sjasi3/ECE445/notebooks/Sean/ECE445 Journal/Pasted image 20260427105520.png

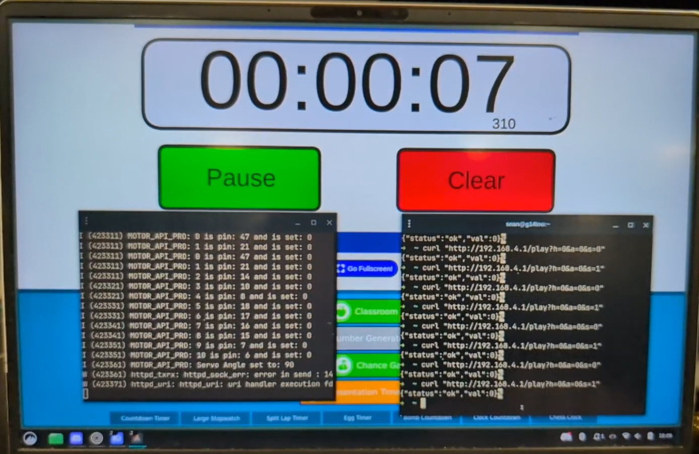
notebooks/Sean/ECE445 Journal/Pasted image 20260427105520.png
