sjasi3/ECE445/notebooks/Sean/ECE445 Journal/Pasted image 20260310155944.png

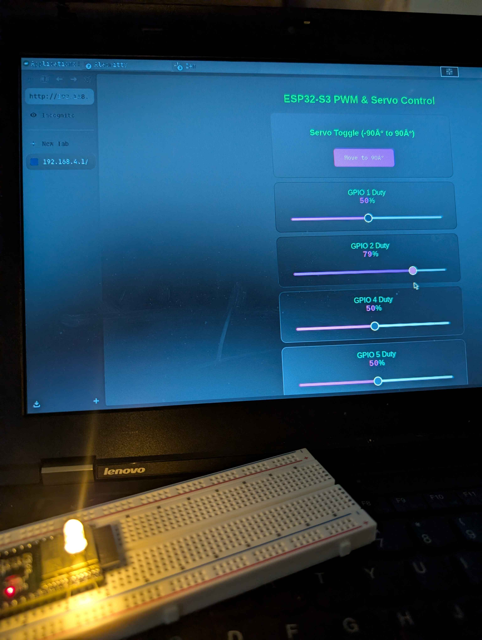
notebooks/Sean/ECE445 Journal/Pasted image 20260310155944.png
