sjasi3/ECE445/notebooks/David/image.png

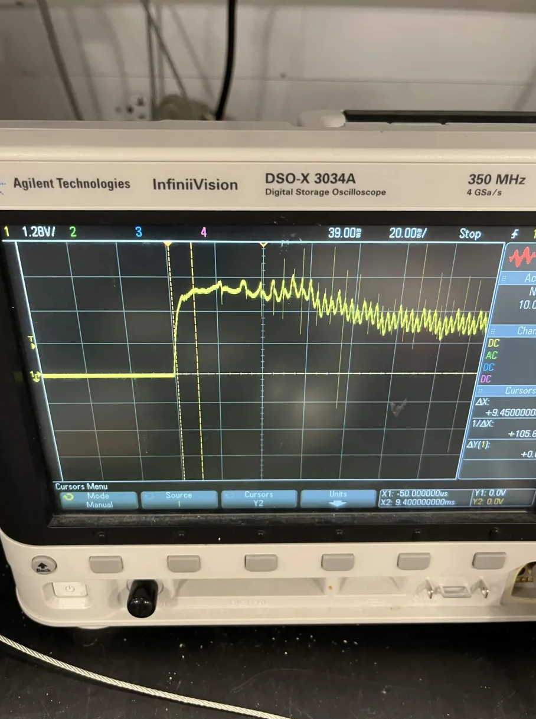
notebooks/David/image.png
