sjasi3/ECE445/notebooks/David/IMG_9398.jpg

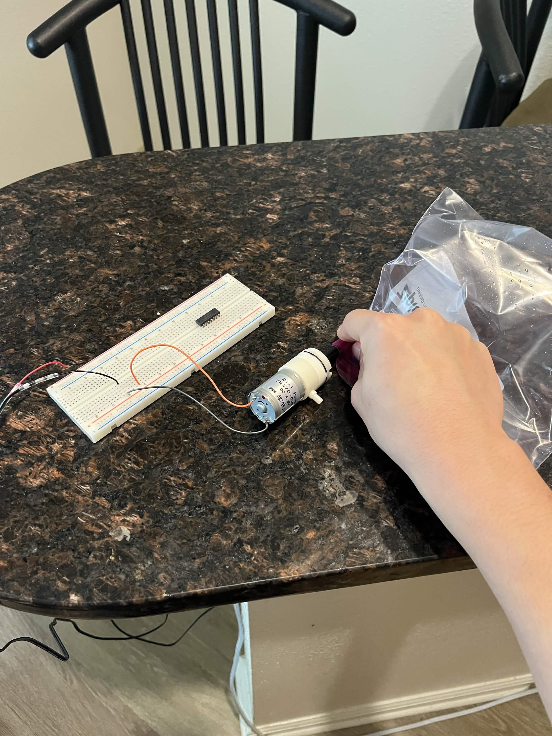
notebooks/David/IMG_9398.jpg
