sjasi3/ECE445/notebooks/David/IMG_9528.jpg

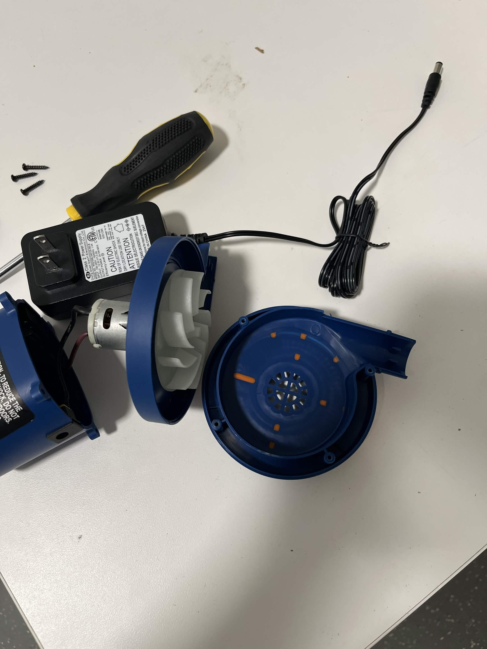
notebooks/David/IMG_9528.jpg
