sjasi3/ECE445/notebooks/David/IMG_9540.jpg

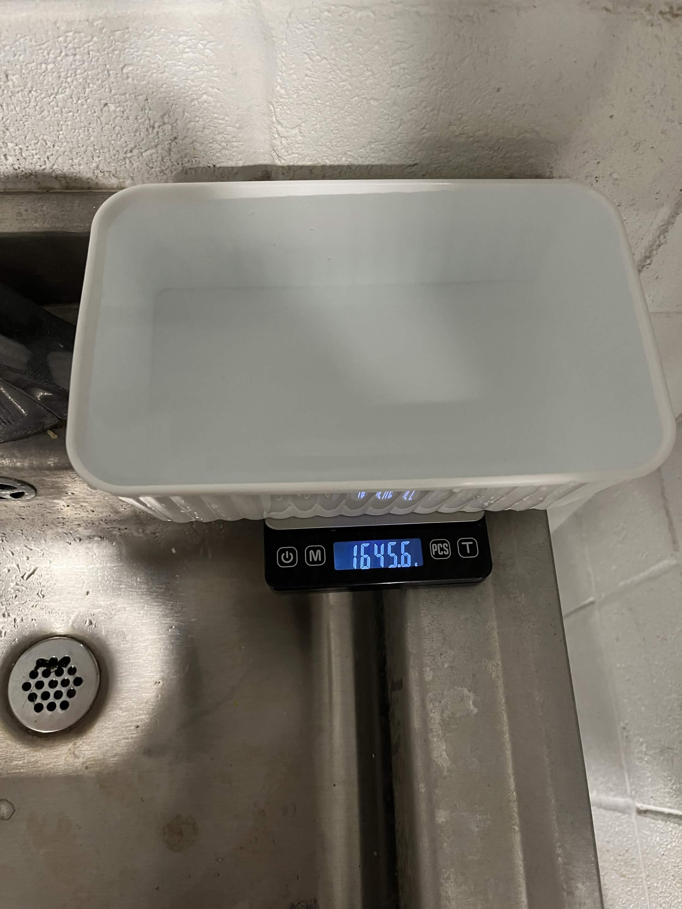
notebooks/David/IMG_9540.jpg
