sjasi3/ECE445/notebooks/David/IMG_9541.jpg

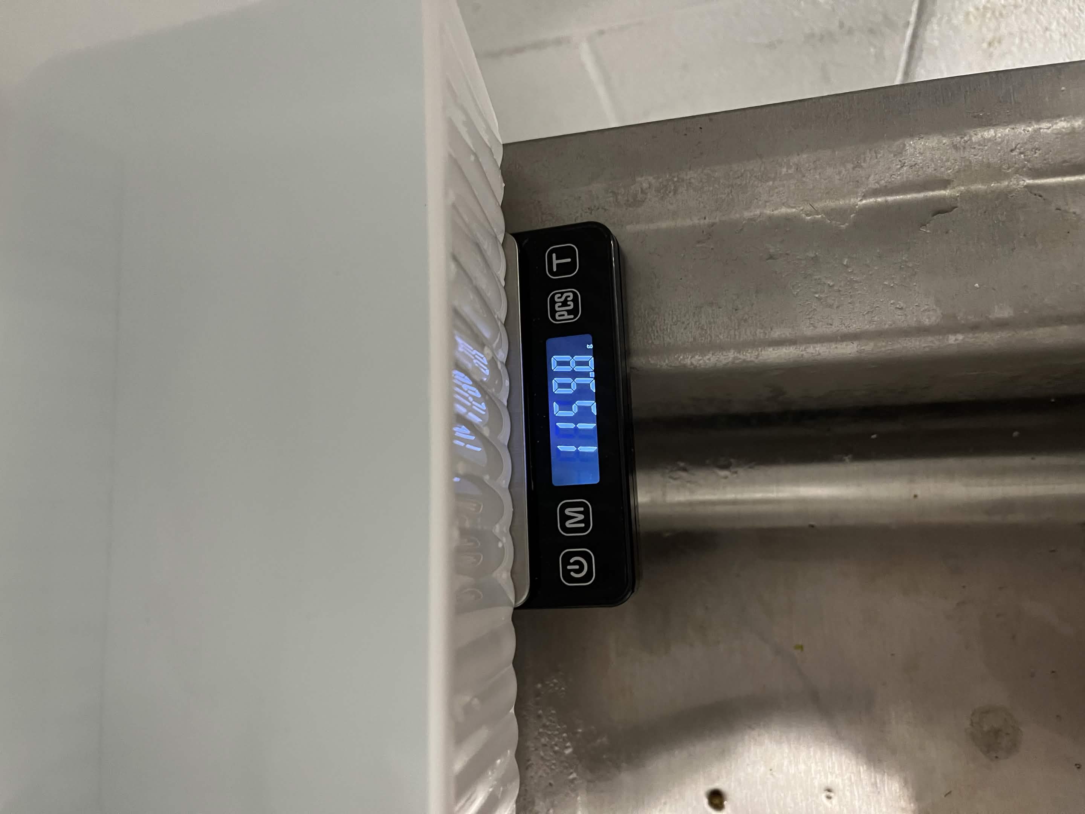
notebooks/David/IMG_9541.jpg
