sjasi3/ECE445/notebooks/robertz4/2_26 PCB Design/2_26 Figure 2 Types of motor and solenoid drivers.jpg

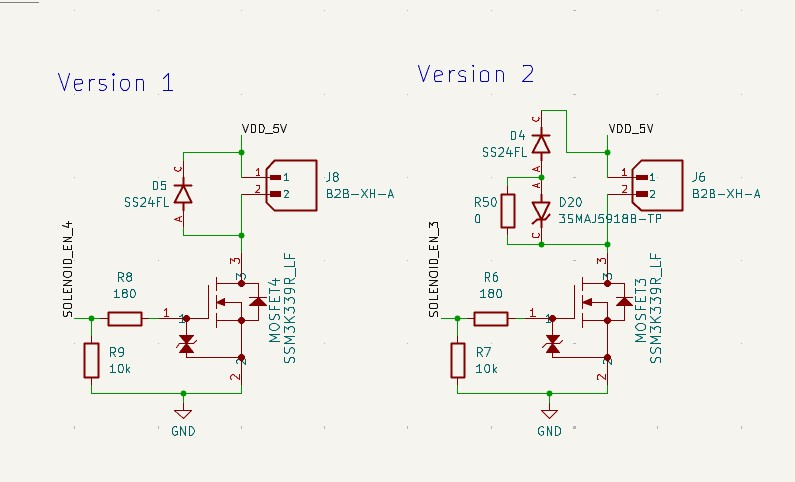
notebooks/robertz4/2_26 PCB Design/2_26 Figure 2 Types of motor and solenoid drivers.jpg
