sjasi3/ECE445/notebooks/robertz4/3_9 Prototyping for breadboard demo/3_9 Figure 4 solenoid current profile.jpg

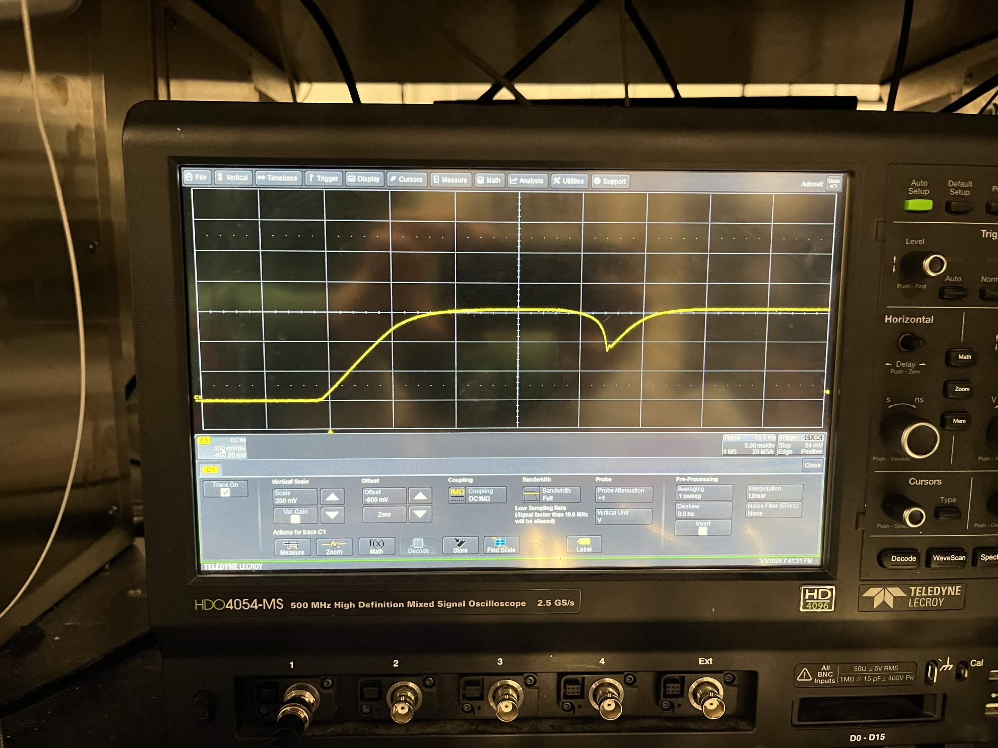
notebooks/robertz4/3_9 Prototyping for breadboard demo/3_9 Figure 4 solenoid current profile.jpg
