sjasi3/ECE445/notebooks/robertz4/3_9 Prototyping for breadboard demo/3_9 Figure 5 noise plot.jpg

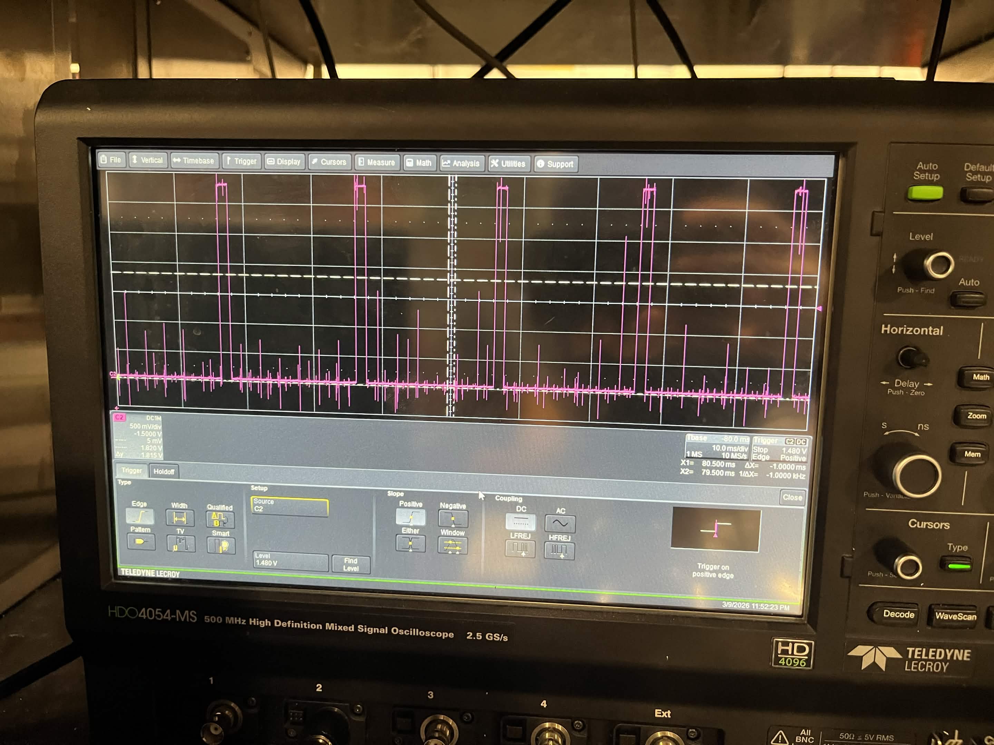
notebooks/robertz4/3_9 Prototyping for breadboard demo/3_9 Figure 5 noise plot.jpg
