sjasi3/ECE445/notebooks/robertz4/4_24 CAD for final demo/t_joint_v2.stl

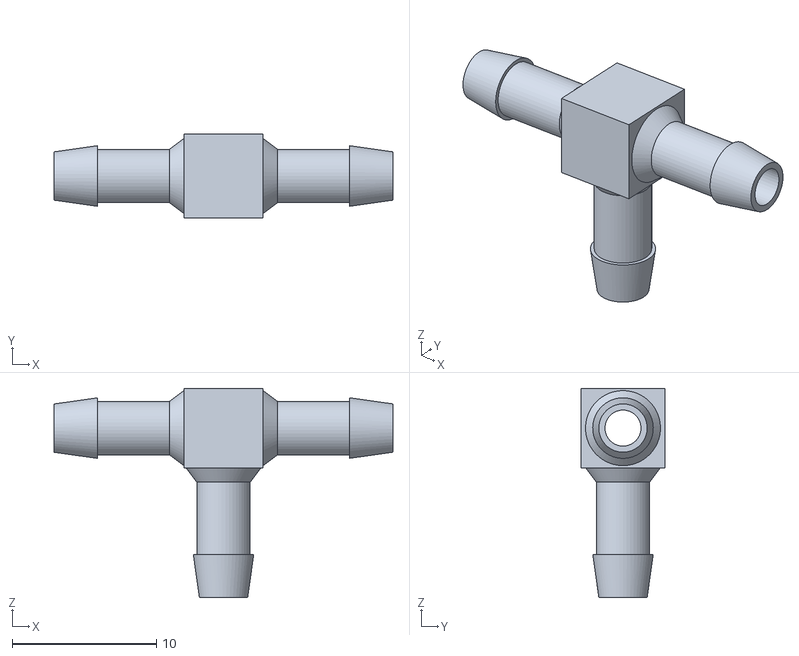
[picture p11: CAD file, 2026-04-27]
notebooks/robertz4/4_24 CAD for final demo/t_joint_v2.stl
23.5 x 5.80 x 14.5
