sjasi3/ECE445/notebooks/robertz4/4_24 CAD for final demo/solenoid_cap_v6.stl

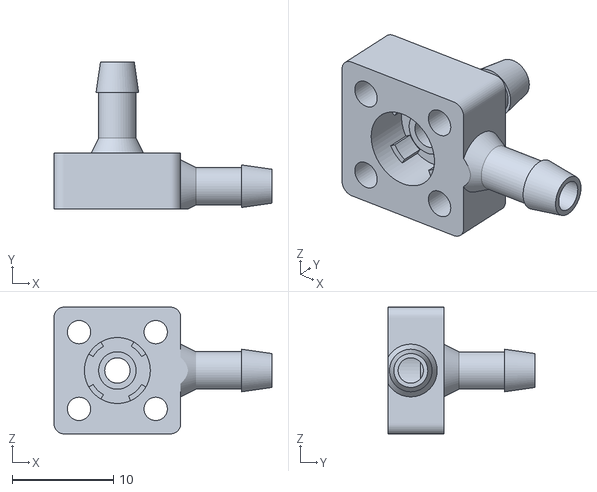
[picture p12: CAD file, 2026-04-27]
notebooks/robertz4/4_24 CAD for final demo/solenoid_cap_v6.stl
21.5 x 14.5 x 12.5
