sjasi3/ECE445/notebooks/robertz4/4_25 Testing for final demo/4_25 Figure 9 3.3V ripple.png

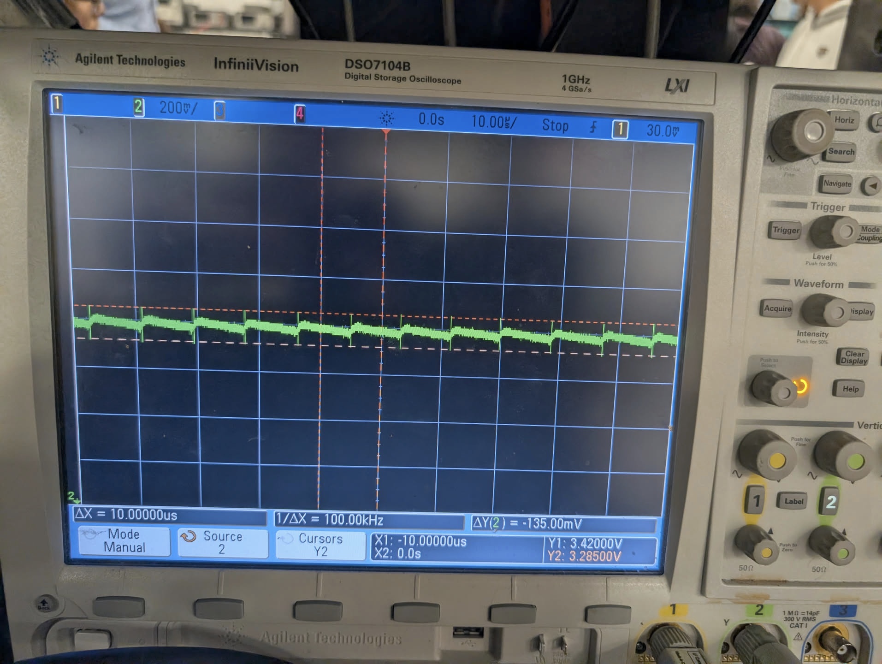
notebooks/robertz4/4_25 Testing for final demo/4_25 Figure 9 3.3V ripple.png
