sjasi3/ECE445/notebooks/Sean/ECE445 Journal/Pasted image 20260310155955.png

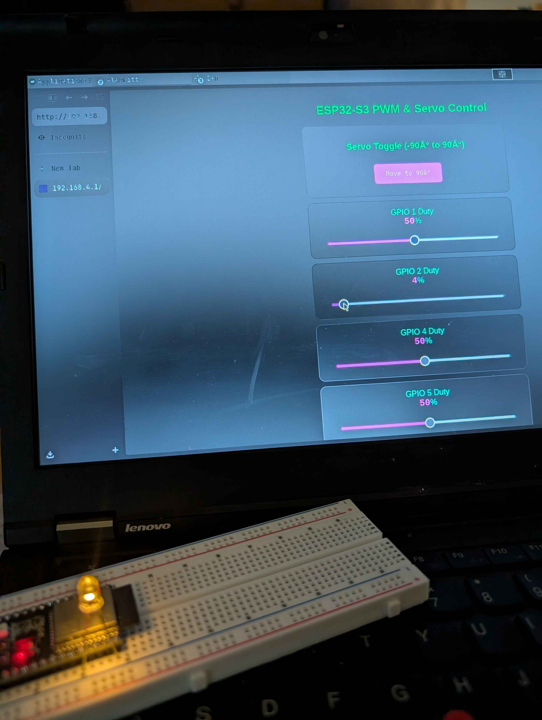
notebooks/Sean/ECE445 Journal/Pasted image 20260310155955.png
