sjasi3/ECE445/notebooks/robertz4/3_26 PCB round 4/3_27 Figure 8 PCB round 4 schematic.pdf

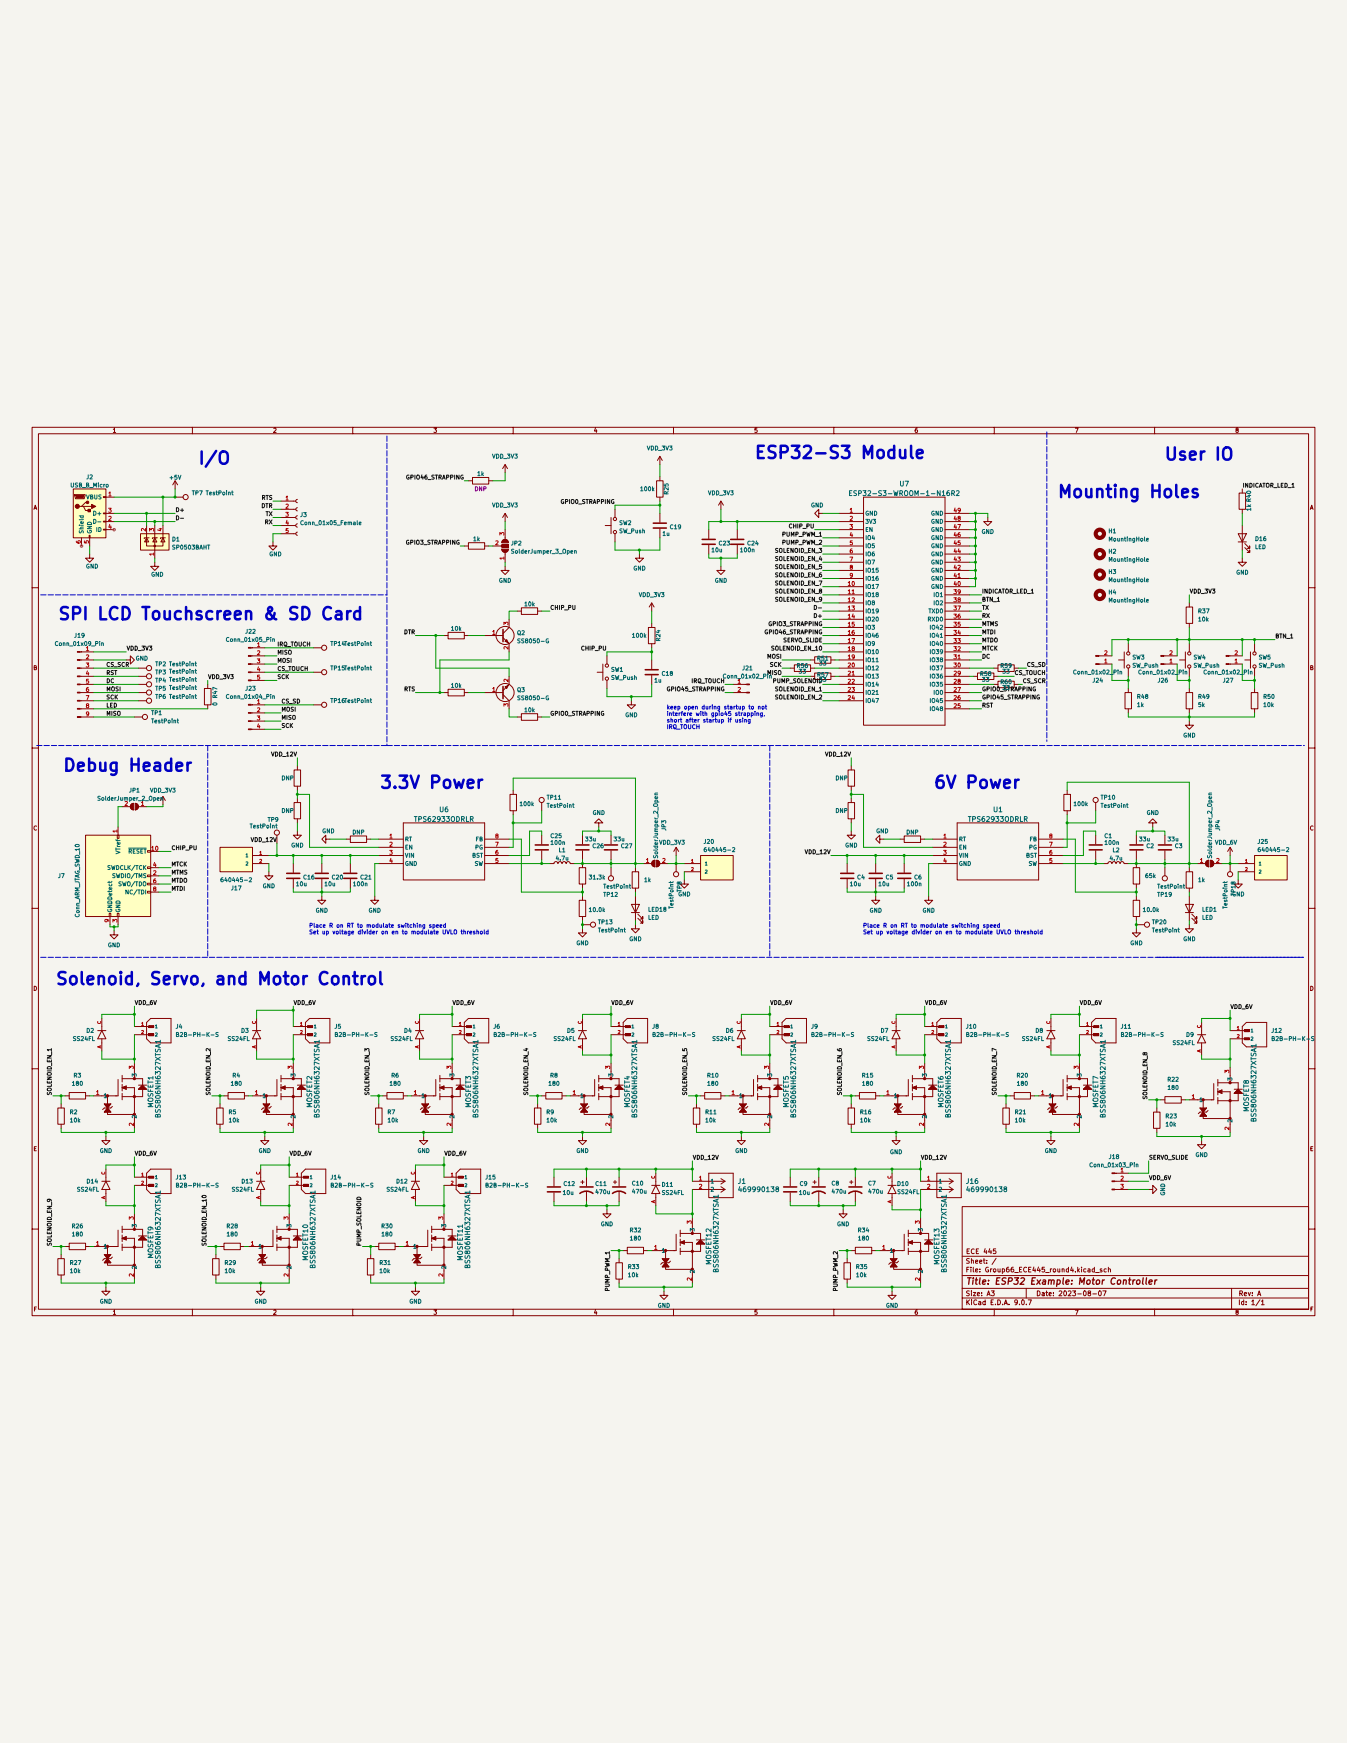
[picture p21: page 1]
