sjasi3/ECE445/notebooks/robertz4/3_12 PCB round 3/3_12 Figure 6 PCB round 3 Schematic.pdf

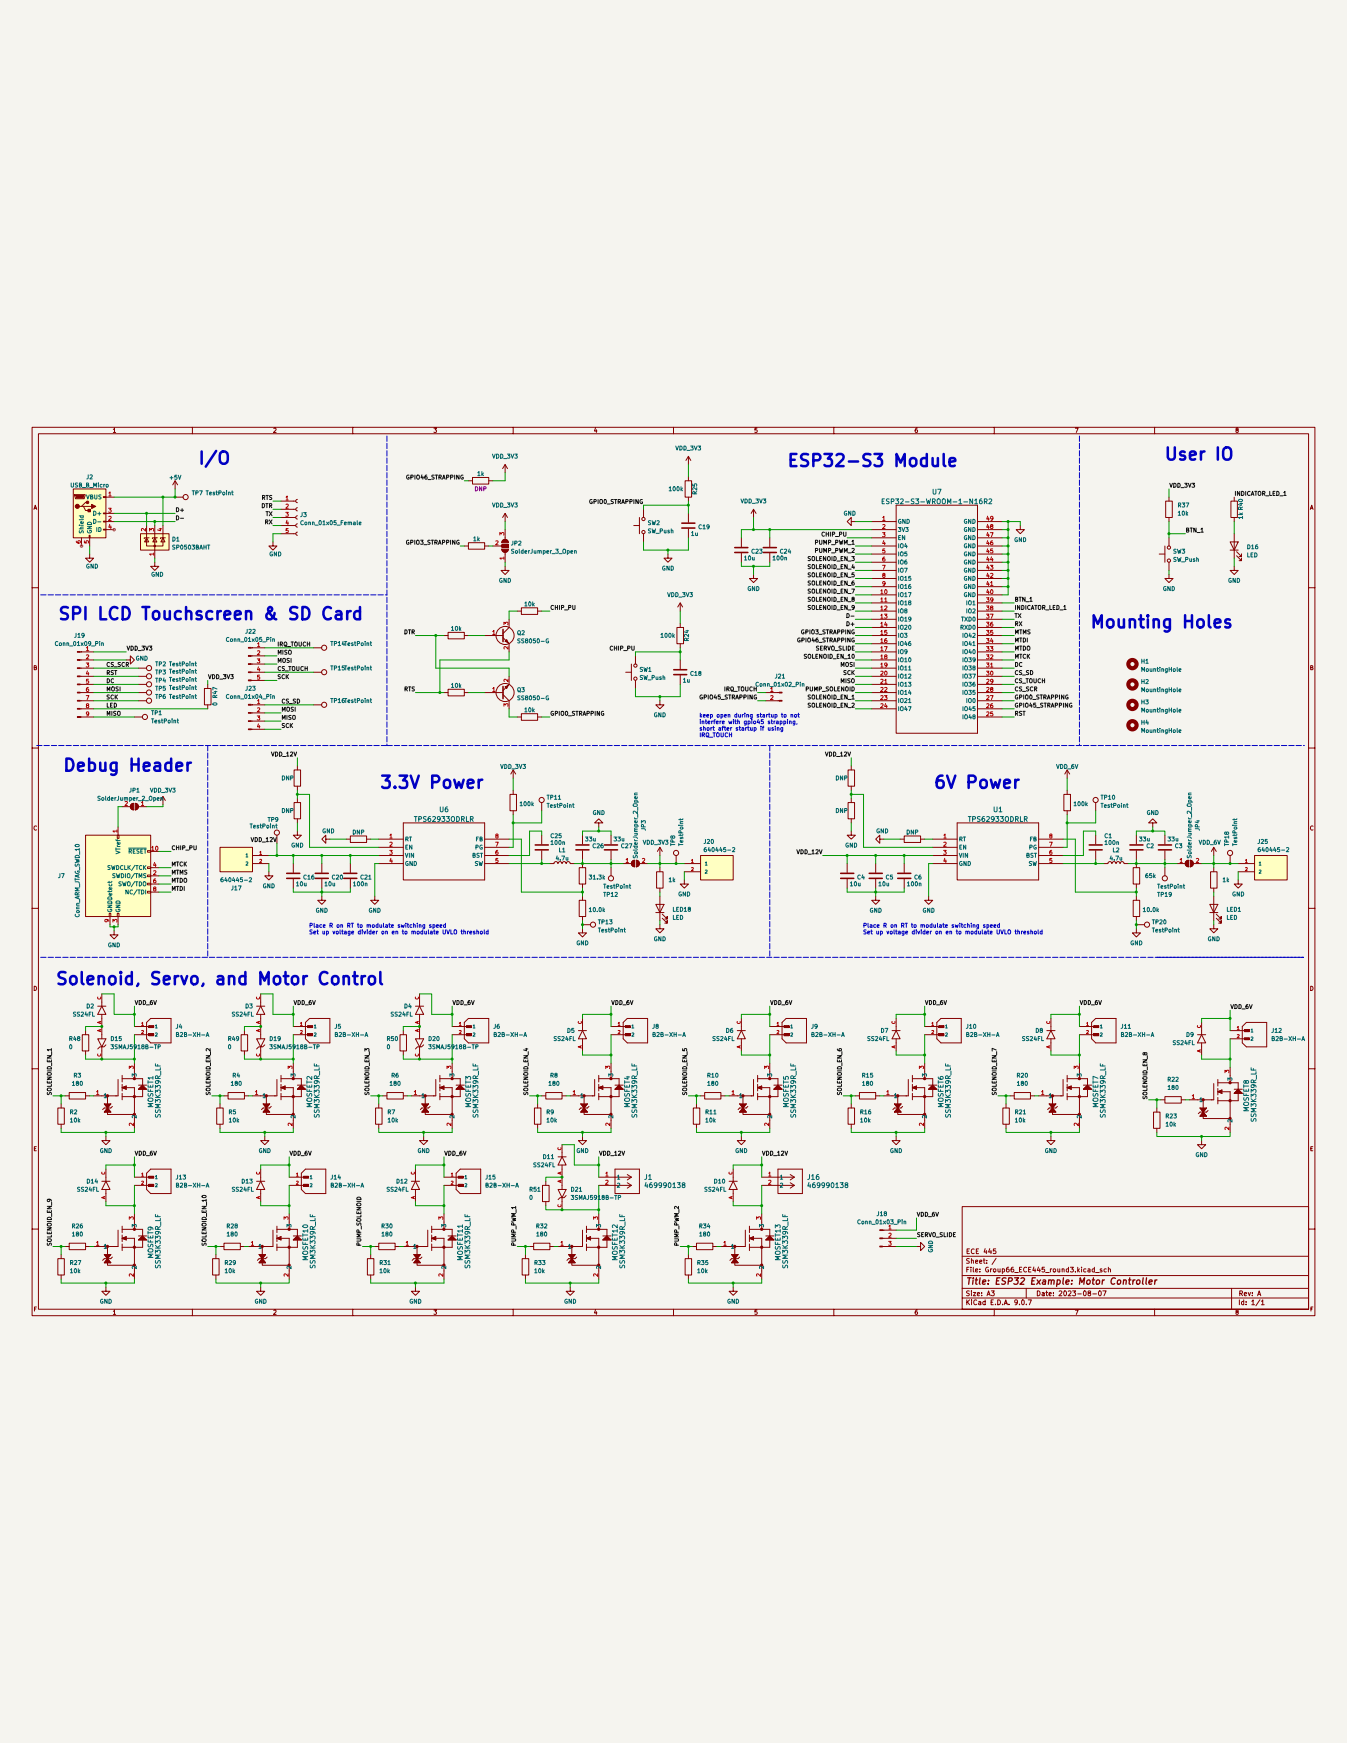
[picture p22: page 1]
