sjasi3/ECE445/notebooks/robertz4/2_26 PCB Design/2_26 Figure 3 PCB round 1 layout.pdf

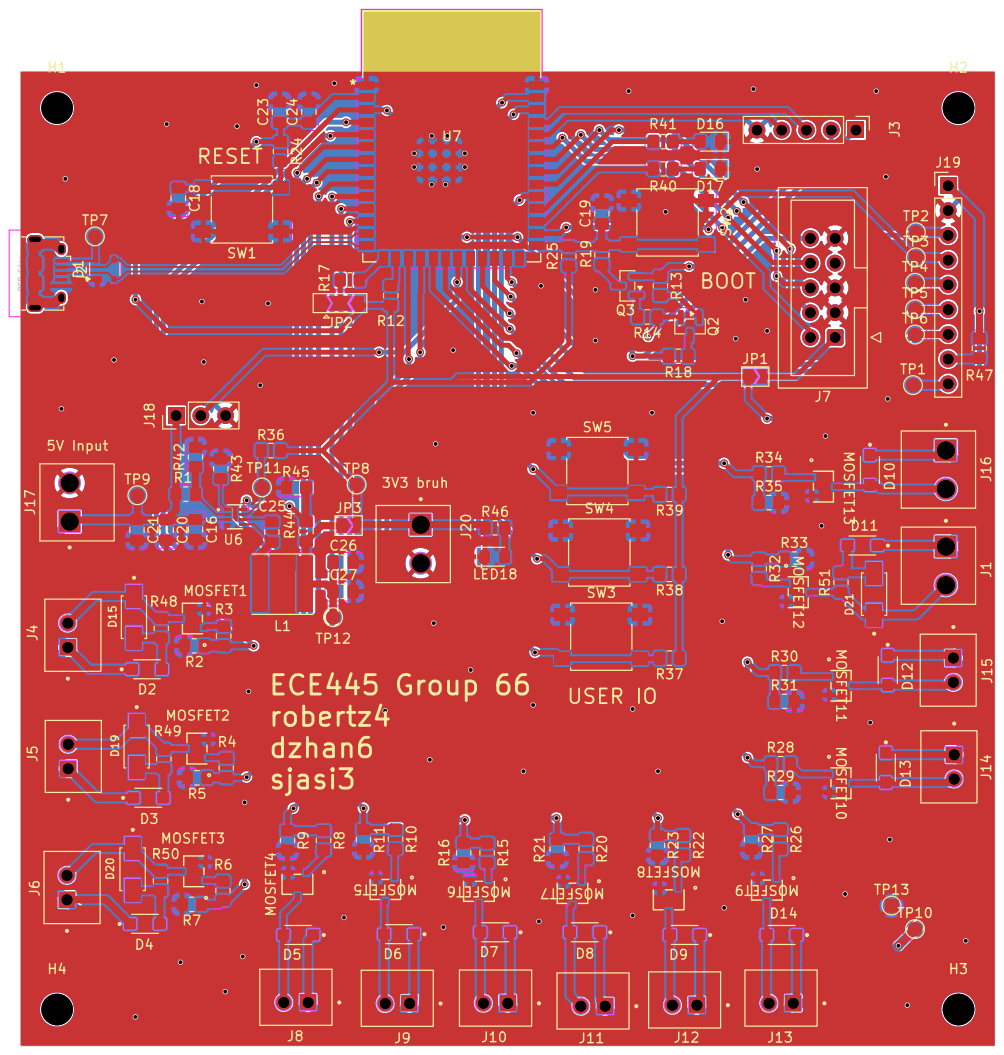
[picture p23: page 1]
