sjasi3/ECE445/notebooks/robertz4/2_26 PCB Design/2_26 Figure 1 PCB round 1 schematic.pdf

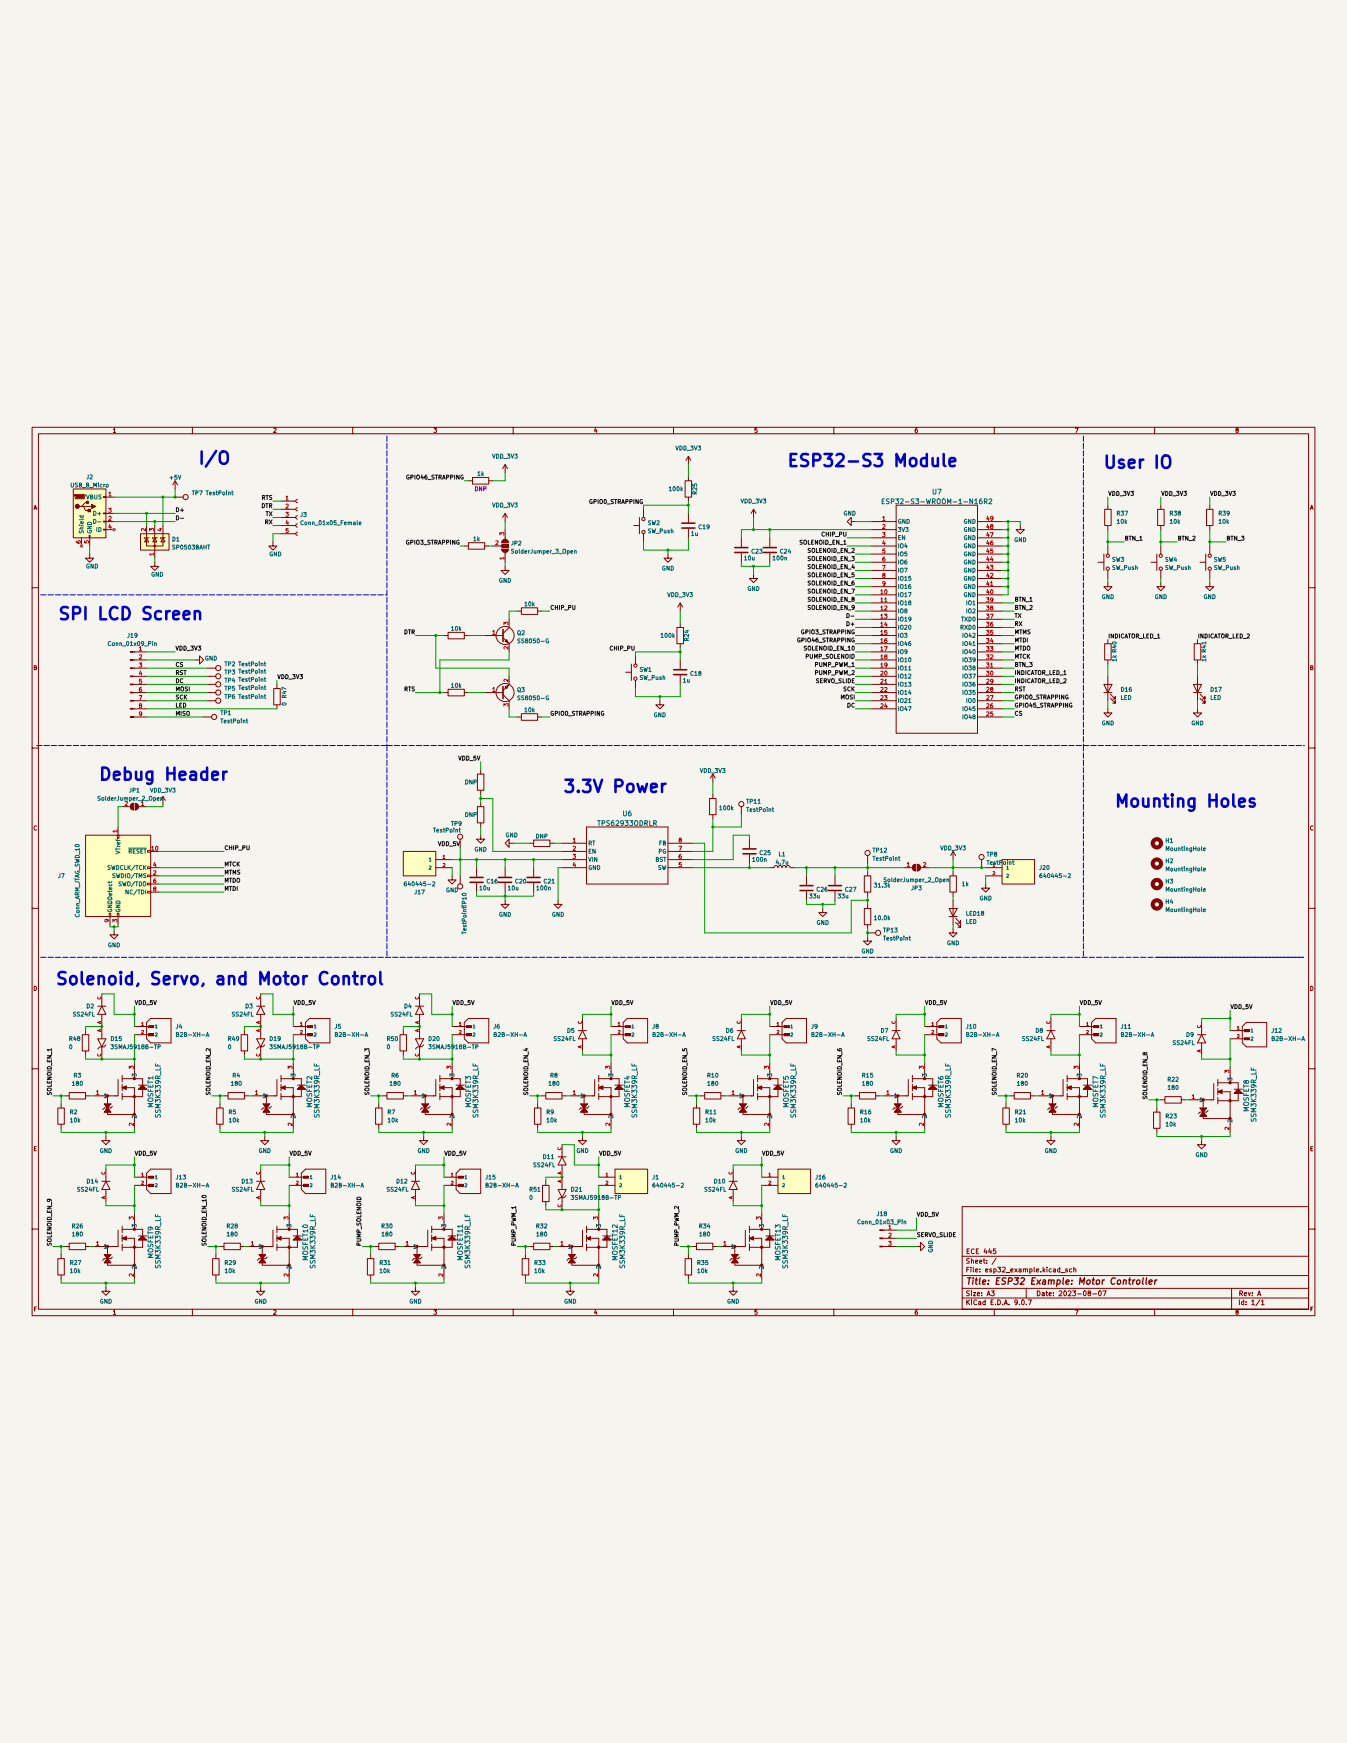
[picture p24: page 1]
