sjasi3/ECE445/notebooks/robertz4/3_26 PCB round 4/3_27 Figure 7 PCB round 4 layout.pdf

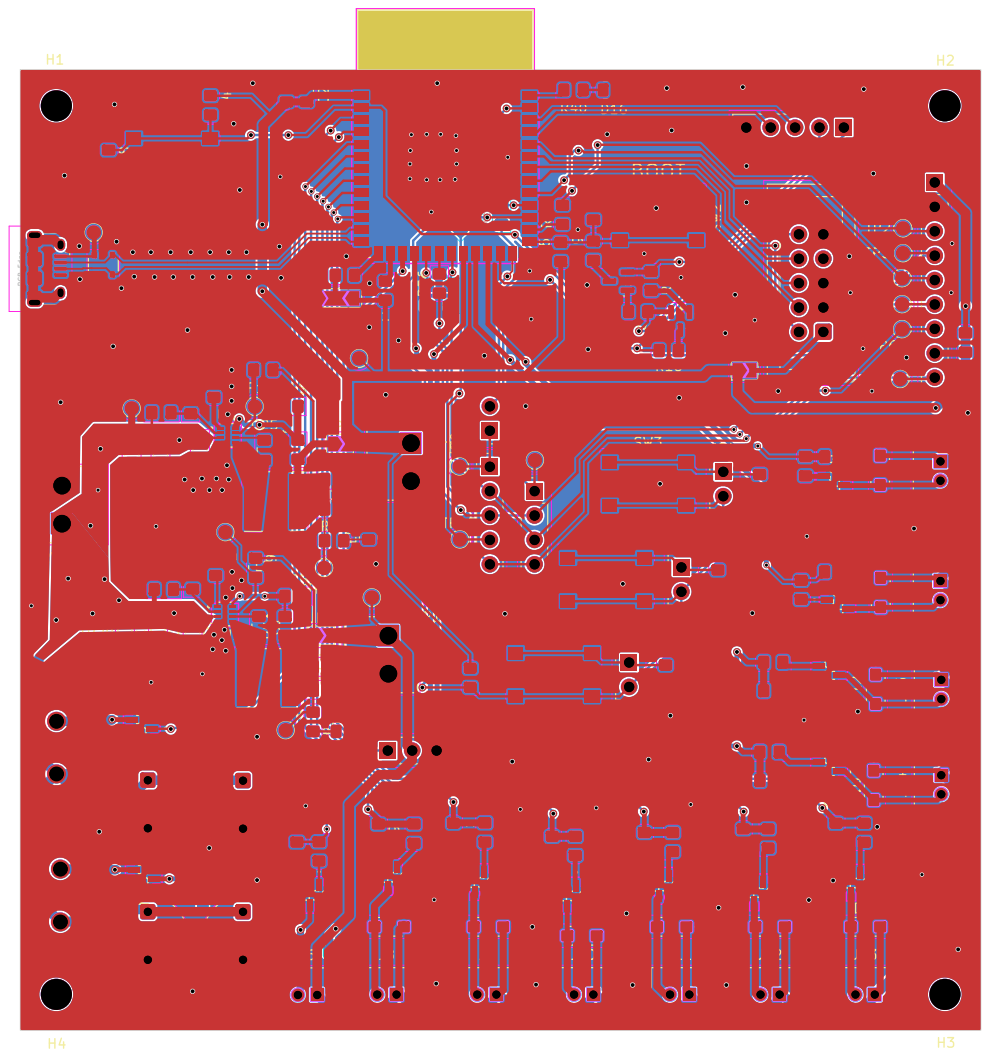
[picture p25: page 1]
