sjasi3/ECE445/Group66_ECE445_round4/Group66_ECE445_round4.kicad_pcb

## KiCad design Group66_ECE445_round4/Group66_ECE445_round4.kicad_pcb (2026-05-07)

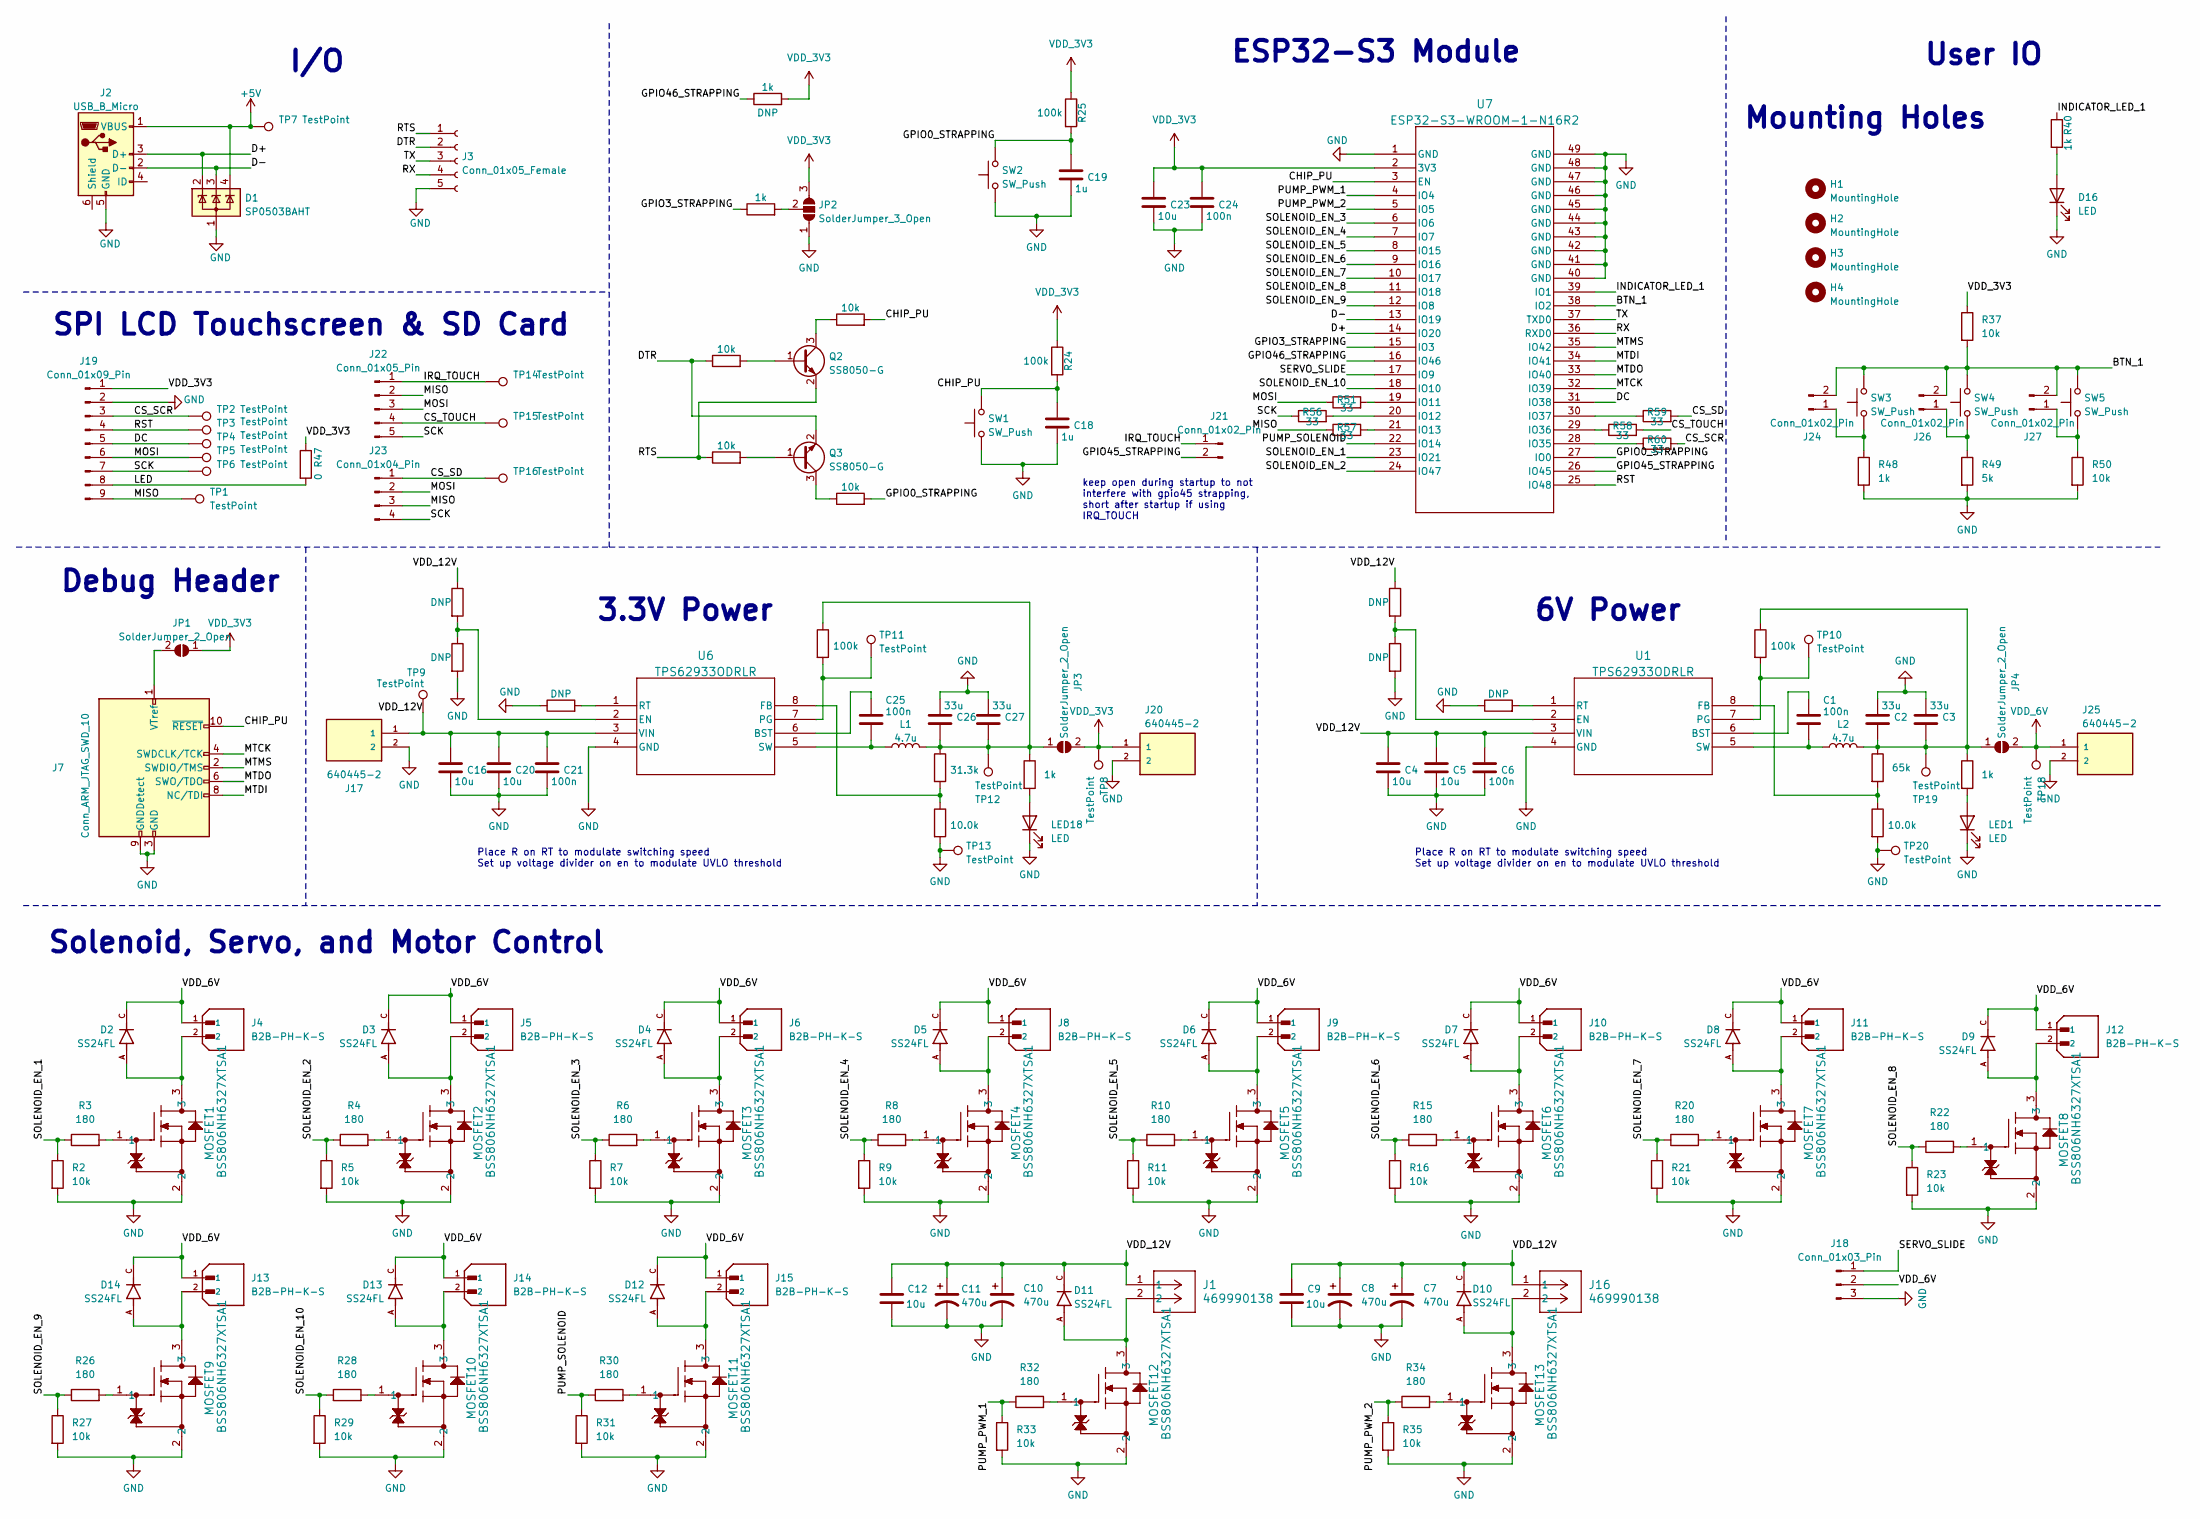
[picture p26: schematic Group66_ECE445_round4.kicad_sch, ESP32 Example: Motor Controller]

Parts:
C1, C6, C21, C24, C25: 100n; C_0805_2012Metric_Pad1.18x1.45mm_HandSolder
C2, C3, C26, C27: 33u; C_0805_2012Metric_Pad1.18x1.45mm_HandSolder
C4, C5, C9, C12, C16, C20, C23: 10u; C_0805_2012Metric_Pad1.18x1.45mm_HandSolder
C7, C8, C10, C11: 470u; CP_Radial_D8.0mm_P5.00mm
C18, C19: 1u; C_0805_2012Metric_Pad1.18x1.45mm_HandSolder
D1: SP0503BAHT; SOT-143
D2, D3, D4, D5, D6, D7, D8, D9, D10, D11, D12, D13, D14: SS24FL; SODFL3617X108N; PARTREV A
D16: LED; LED_0805_2012Metric_Pad1.15x1.40mm_HandSolder
H1, H2, H3, H4: MountingHole; MountingHole_3.2mm_M3
J1, J16: 469990138; CONN_SD-5566-002_02_MOL
J2: USB_B_Micro; USB_Micro-B_Amphenol_10118194_Horizontal
J3: Conn_01x05_Female; PinHeader_1x05_P2.54mm_Vertical
J4, J5, J6, J8, J9, J10, J11, J12, J13, J14, J15: B2B-PH-K-S; JST_B2B-PH-K-S; PARTREV N/A
J7: Conn_ARM_JTAG_SWD_10; IDC-Header_2x05_P2.54mm_Vertical
J17, J20, J25: 640445-2; TE_640445-2; PARTREV R
J18: Conn_01x03_Pin; PinHeader_1x03_P2.54mm_Vertical
J19: Conn_01x09_Pin; PinHeader_1x09_P2.54mm_Vertical
J21, J24, J26, J27: Conn_01x02_Pin; PinHeader_1x02_P2.54mm_Vertical
J22: Conn_01x05_Pin; PinHeader_1x05_P2.54mm_Vertical
J23: Conn_01x04_Pin; PinHeader_1x04_P2.54mm_Vertical
JP1, JP3, JP4: SolderJumper_2_Open; SolderJumper-2_P1.3mm_Open_TrianglePad1.0x1.5mm
JP2: SolderJumper_3_Open; SolderJumper-3_P2.0mm_Open_TrianglePad1.0x1.5mm
L1, L2: 4.7u; L_Taiyo-Yuden_NR-60xx
LED1, LED18: LED; LED_0805_2012Metric_Pad1.15x1.40mm_HandSolder
MOSFET1, MOSFET2, MOSFET3, MOSFET4, MOSFET5, MOSFET6, MOSFET7, MOSFET8, MOSFET9, MOSFET10, MOSFET11, MOSFET12, MOSFET13: BSS806NH6327XTSA1; SOT23_BSS806NH6327XTSA1_INF
Q2, Q3: SS8050-G; SOT-23
R1, R38, R41, R42, R43, R52: DNP; R_0805_2012Metric_Pad1.20x1.40mm_HandSolder
R2, R5, R7, R9, R11, R13, R14, R16, R18, R19, R21, R23, R27, R29, R31, R33, R35, R37, R50: 10k; R_0805_2012Metric_Pad1.20x1.40mm_HandSolder
R3, R4, R6, R8, R10, R15, R20, R22, R26, R28, R30, R32, R34: 180; R_0805_2012Metric_Pad1.20x1.40mm_HandSolder
R12, R17, R40, R46, R48, R54: 1k; R_0805_2012Metric_Pad1.20x1.40mm_HandSolder
R24, R25, R36, R39: 100k; R_0805_2012Metric_Pad1.20x1.40mm_HandSolder
R44: 31.3k; R_0805_2012Metric_Pad1.20x1.40mm_HandSolder
R45, R55: 10.0k; R_0805_2012Metric_Pad1.20x1.40mm_HandSolder
R47: 0; R_0805_2012Metric_Pad1.20x1.40mm_HandSolder
R49: 5k; R_0805_2012Metric_Pad1.20x1.40mm_HandSolder
R51, R56, R57, R58, R59, R60: 33; R_0805_2012Metric_Pad1.20x1.40mm_HandSolder
R53: 65k; R_0805_2012Metric_Pad1.20x1.40mm_HandSolder
SW1, SW2, SW3, SW4, SW5: SW_Push; SW_SPST_B3S-1000
TP1, TP2, TP3, TP4, TP5, TP6, TP7, TP8, TP9, TP10, TP11, TP12, TP13, TP14, TP15, TP16, TP18, TP19, TP20: TestPoint; TestPoint_Pad_D1.5mm
U1, U6: TPS62933ODRLR; SOT5X3-8_DRL_TEX
U7: ESP32-S3-WROOM-1-N16R2; ESP32-S3-WROOM-1_EXP

Connections:
+5V: D1.4 (K), J2.1 (VBUS), TP7.1
/BTN_1: J24.2, J26.2, J27.2, R37.2, SW3.2, SW4.2, SW5.2, U7.38 (IO2)
/CHIP_PU: C18.1, J7.10 (~RESET), R18.2, R24.2, SW1.2, U7.3 (EN)
/CS_SCR: J19.3, R60.2, TP2.1
/CS_SD: J23.1, R59.2, TP16.1
/CS_TOUCH: J22.4, R58.2, TP15.1
/D+: D1.2 (K), J2.3 (D+), U7.14 (IO20)
/D-: D1.3 (K), J2.2 (D-), U7.13 (IO19)
/DC: J19.5, TP4.1, U7.31 (IO38)
/DTR: J3.2, Q3.2 (E), R13.1
/GPIO0_STRAPPING: C19.1, R19.2, R25.2, SW2.2, U7.27 (IO0)
/GPIO3_STRAPPING: R17.1, U7.15 (IO3)
/GPIO45_STRAPPING: J21.2, U7.26 (IO45)
/GPIO46_STRAPPING: R12.1, U7.16 (IO46)
/INDICATOR_LED_1: R40.1, U7.39 (IO1)
/IRQ_TOUCH: J21.1, J22.1, TP14.1
/LED: J19.8, R47.2
/MISO: J19.9, J22.2, J23.3, R57.1, TP1.1
/MOSI: J19.6, J22.3, J23.2, R51.1, TP5.1
/MTCK: J7.4 (SWDCLK/TCK), U7.32 (IO39)
/MTDI: J7.8 (NC/TDI), U7.34 (IO41)
/MTDO: J7.6 (SWO/TDO), U7.33 (IO40)
/MTMS: J7.2 (SWDIO/TMS), U7.35 (IO42)
/PUMP_PWM_1: R32.1, R33.1, U7.4 (IO4)
/PUMP_PWM_2: R34.1, R35.1, U7.5 (IO5)
/PUMP_SOLENOID: R30.1, R31.1, U7.22 (IO14)
/RST: J19.4, TP3.1, U7.25 (IO48)
/RTS: J3.1, Q2.2 (E), R14.1
/RX: J3.4, U7.36 (RXD0)
/SCK: J19.7, J22.5, J23.4, R56.1, TP6.1
/SERVO_SLIDE: J18.1, U7.17 (IO9)
/SOLENOID_EN_1: R2.1, R3.1, U7.23 (IO21)
/SOLENOID_EN_2: R4.1, R5.1, U7.24 (IO47)
/SOLENOID_EN_3: R6.1, R7.1, U7.6 (IO6)
/SOLENOID_EN_4: R8.1, R9.1, U7.7 (IO7)
/SOLENOID_EN_5: R10.1, R11.1, U7.8 (IO15)
/SOLENOID_EN_6: R15.1, R16.1, U7.9 (IO16)
/SOLENOID_EN_7: R20.1, R21.1, U7.10 (IO17)
/SOLENOID_EN_8: R22.1, R23.1, U7.11 (IO18)
/SOLENOID_EN_9: R26.1, R27.1, U7.12 (IO8)
/SOLENOID_EN_10: R28.1, R29.1, U7.18 (IO10)
/TX: J3.3, U7.37 (TXD0)
/VDD_12V: C4.1, C5.1, C6.1, C7.1, C8.1, C9.1, C10.1, C11.1, C12.1, C16.1, C20.1, C21.1, D10.C, D11.C, J1.1, J16.1, J17.1, R1.1, R38.1, TP9.1, U1.3 (VIN), U6.3 (VIN)
GND: C2.2, C3.2, C4.2, C5.2, C6.2, C7.2, C8.2, C9.2, C10.2, C11.2, C12.2, C16.2, C18.2, C19.2, C20.2, C21.2, C23.2, C24.2, C26.2, C27.2, D1.1 (A), D16.1 (K), J2.5 (GND), J3.5, J7.3 (GND), J7.5 (GND), J7.9 (GNDDetect), J17.2, J18.3, J19.2, J20.2, J25.2, JP2.1 (A), LED1.1 (K), LED18.1 (K), MOSFET1.2, MOSFET2.2, MOSFET3.2, MOSFET4.2, MOSFET5.2, MOSFET6.2, MOSFET7.2, MOSFET8.2, MOSFET9.2, MOSFET10.2, MOSFET11.2, MOSFET12.2, MOSFET13.2, R2.2, R5.2, R7.2, R9.2, R11.2, R16.2, R21.2, R23.2, R27.2, R29.2, R31.2, R33.2, R35.2, R41.2, R42.2, R43.1, R45.2, R48.2, R49.2, R50.2, R52.1, R55.2, SW1.1, SW2.1, TP13.1, TP20.1, U1.4 (GND), U6.4 (GND), U7.1 (GND), U7.40 (GND), U7.41 (GND), U7.42 (GND), U7.43 (GND), U7.44 (GND), U7.45 (GND), U7.46 (GND), U7.47 (GND), U7.48 (GND), U7.49 (GND)
unnamed: D2.A, J4.2, MOSFET1.3
unnamed: D3.A, J5.2, MOSFET2.3
unnamed: D4.A, J6.2, MOSFET3.3
unnamed: D5.A, J8.2, MOSFET4.3
unnamed: D6.A, J9.2, MOSFET5.3
unnamed: D7.A, J10.2, MOSFET6.3
unnamed: D8.A, J11.2, MOSFET7.3
unnamed: D9.A, J12.2, MOSFET8.3
unnamed: D10.A, J16.2, MOSFET13.3
unnamed: D11.A, J1.2, MOSFET12.3
unnamed: D12.A, J15.2, MOSFET11.3
unnamed: D13.A, J14.2, MOSFET10.3
unnamed: D14.A, J13.2, MOSFET9.3
unnamed: D16.2 (A), R40.2
unnamed: J7.1 (VTref), JP1.2 (B)
unnamed: J24.1, R48.1, SW3.1
unnamed: J26.1, R49.1, SW4.1
unnamed: J27.1, R50.1, SW5.1
unnamed: JP2.2 (C), R17.2
unnamed: C26.1, C27.1, JP3.1 (A), L1.2, R36.1, R44.1, R46.1, TP12.1
unnamed: C2.1, C3.1, JP4.1 (A), L2.2, R39.1, R53.1, R54.1, TP19.1
unnamed: LED1.2 (A), R54.2
unnamed: LED18.2 (A), R46.2
unnamed: MOSFET1.1, R3.2
unnamed: MOSFET2.1, R4.2
unnamed: MOSFET3.1, R6.2
unnamed: MOSFET4.1, R8.2
unnamed: MOSFET5.1, R10.2
unnamed: MOSFET6.1, R15.2
unnamed: MOSFET7.1, R20.2
unnamed: MOSFET8.1, R22.2
unnamed: MOSFET9.1, R26.2
unnamed: MOSFET10.1, R28.2
unnamed: MOSFET11.1, R30.2
unnamed: MOSFET12.1, R32.2
unnamed: MOSFET13.1, R34.2
unnamed: Q2.1 (B), R13.2
unnamed: Q2.3 (C), R18.1
unnamed: Q3.1 (B), R14.2
unnamed: Q3.3 (C), R19.1
unnamed: C1.1, U1.6 (BST)
unnamed: R38.2, R41.1, U1.2 (EN)
unnamed: R53.2, R55.1, U1.8 (FB)
unnamed: R39.2, TP10.1, U1.7 (PG)
unnamed: R52.2, U1.1 (RT)
unnamed: C1.2, L2.1, U1.5 (SW)
unnamed: C25.1, U6.6 (BST)
unnamed: R1.2, R42.1, U6.2 (EN)
unnamed: R44.2, R45.1, U6.8 (FB)
unnamed: R36.2, TP11.1, U6.7 (PG)
unnamed: R43.2, U6.1 (RT)
unnamed: C25.2, L1.1, U6.5 (SW)
unnamed: R51.2, U7.19 (IO11)
unnamed: R56.2, U7.20 (IO12)
unnamed: R57.2, U7.21 (IO13)
unnamed: R60.1, U7.28 (IO35)
unnamed: R58.1, U7.29 (IO36)
unnamed: R59.1, U7.30 (IO37)
VDD_3V3: C23.1, C24.1, J19.1, J20.1, JP1.1 (A), JP2.3 (B), JP3.2 (B), R12.2, R24.1, R25.1, R37.1, R47.1, TP8.1, U7.2 (3V3)
VDD_6V: D2.C, D3.C, D4.C, D5.C, D6.C, D7.C, D8.C, D9.C, D12.C, D13.C, D14.C, J4.1, J5.1, J6.1, J8.1, J9.1, J10.1, J11.1, J12.1, J13.1, J14.1, J15.1, J18.2, J25.1, JP4.2 (B), TP18.1

Notes on the sheet:
keep open during startup to not interfere with gpio45 strapping, short after startup if using IRQ_TOUCH
Place R on RT to modulate switching speed Set up voltage divider on en to modulate UVLO threshold
ESP32-S3 Module
Solenoid, Servo, and Motor Control
6V Power
User IO
Debug Header
Mounting Holes
3.3V Power
SPI LCD Touchscreen & SD Card
I/O

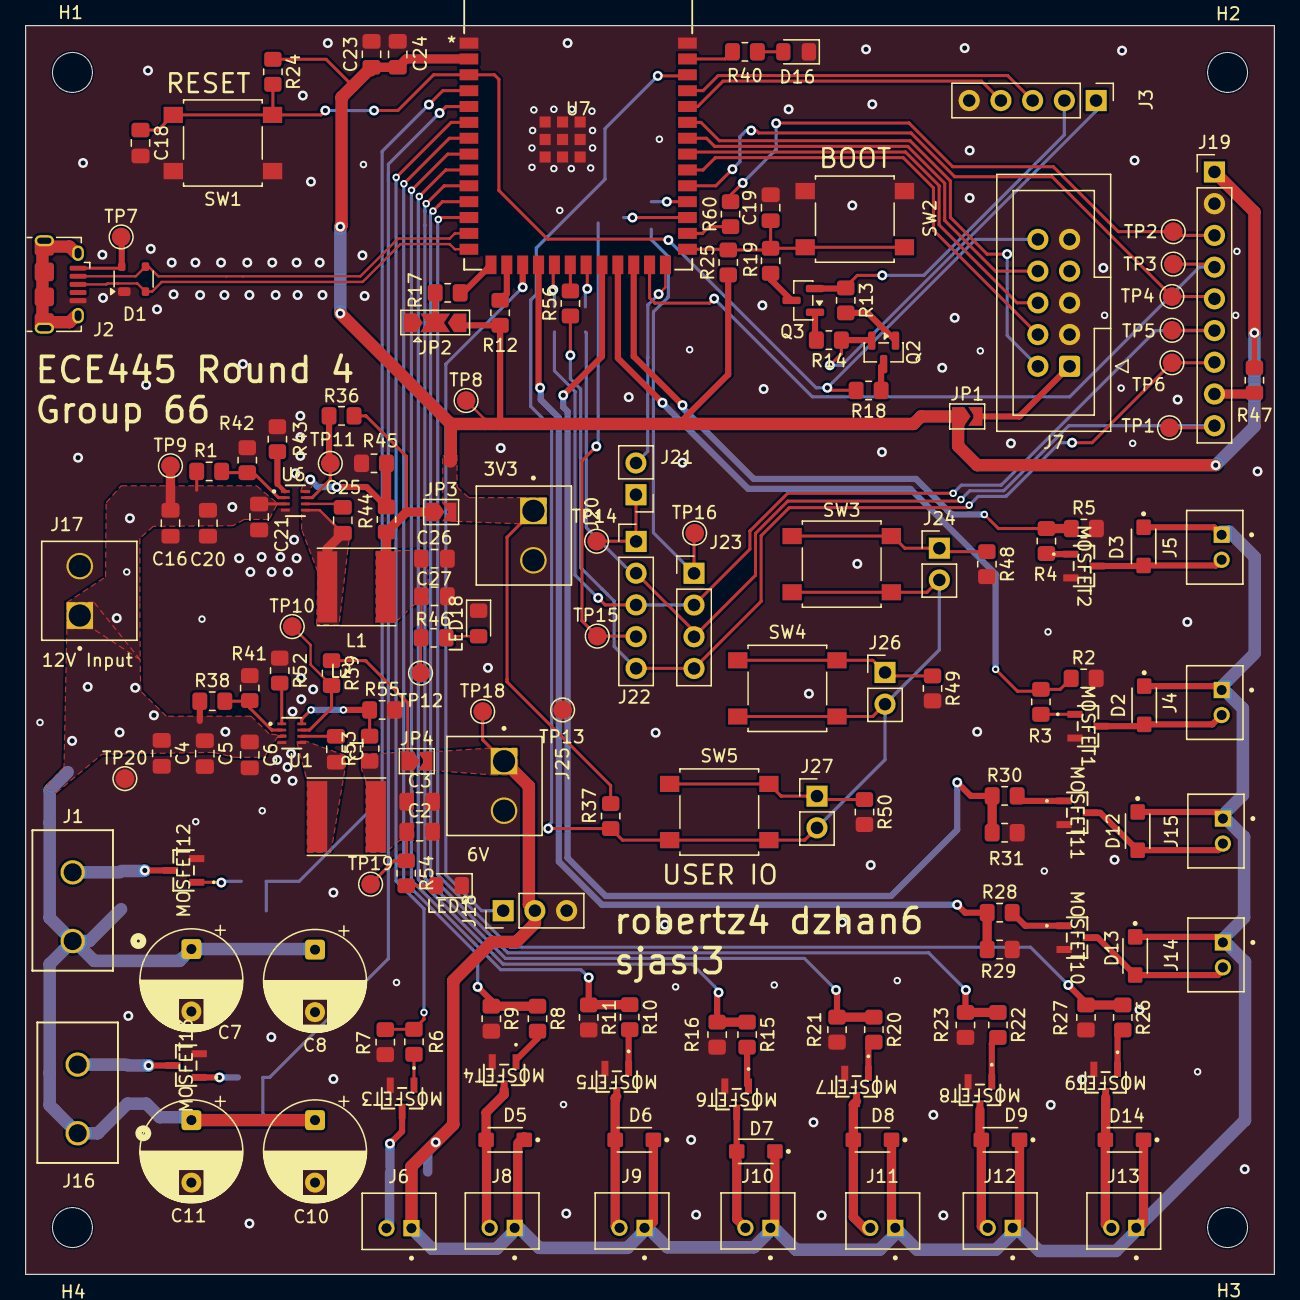
[picture p27: board Group66_ECE445_round4.kicad_pcb from above]

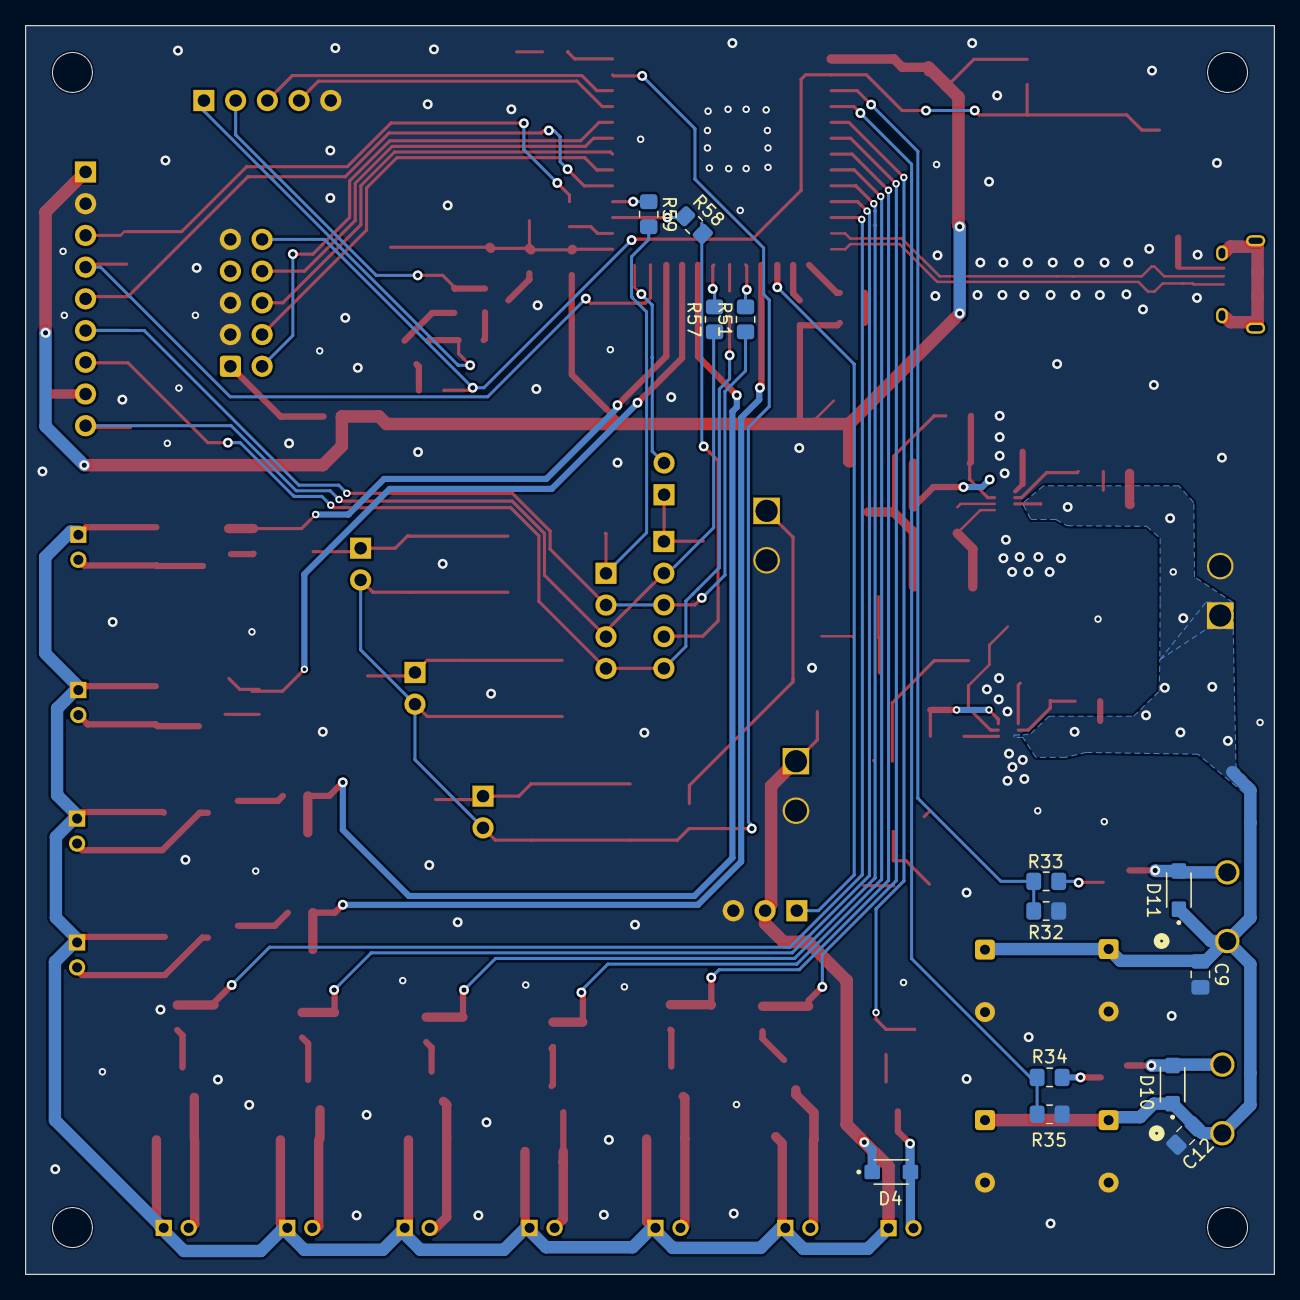
[picture p28: board Group66_ECE445_round4.kicad_pcb from below]

Board: 2 copper layers, 100.0 x 100.0 mm, 178 parts (13 on the bottom side), 104 nets.
