sjasi3/ECE445/(commit log)

2026-03-05 Got wireless code button to function
2026-03-05 3/5/2025 PCB round 2
    New notebook entry for 3/5/2025 detailing changes made to PCB design for round 2
2026-03-05 current curve from solenoid testing
2026-03-12 Rename 3_12 Figure 4 PCB round 3 Schematic.pdf to 3_12 Figure 6 PCB round 3 Schematic.pdf
2026-03-29 Create Notebook entry
    notebook entry for round 4 pcb design 3/26
2026-03-29 Rename notebooks/robertz4/3_5 PCB round 2 to notebooks/robertz4/3_5 PCB Round 2/Notebook entry
2026-05-07 Uploaded files
    Uploaded solenoid air flow testing images from 4/27. Uploaded images of our 12V motor we got from Walmart (04/22). Uploaded air flow testing image for 4.5V DC motor (03.09). Uploaded motor ripple images from the 4.5V DC motor (3/11).
2026-05-07 Reuploaded images.
    Uploaded solenoid air flow testing images from 4/27. Uploaded images of our 12V motor we got from Walmart (04/22). Uploaded air flow testing image for 4.5V DC motor (03.09).
2026-05-07 added code
    [Group66_ECE445_round4-B_Cu.gbl, Group66_ECE445_round4-B_Mask.gbs, Group66_ECE445_round4-B_Paste.gbp, Group66_ECE445_round4-B_Silkscreen.gbo, Group66_ECE445_round4-Edge_Cuts.gm1, Group66_ECE445_round4-F_Cu.gtl, Group66_ECE445_round4-F_Mask.gts, Group66_ECE445_round4-F_Paste.gtp]
